jcnborges/TCC/monografia-tex/final.tex

%---------- Referencias ----------
\bibliography{reflatex} % geracao automatica das referencias a partir do arquivo reflatex.bib

\apendice
\chapter{Referência de Montagem do Robô}

A figura \ref{montagembellator} é uma composição de partes de fotos do robô Bellator em seu estágio final de montagem, ao final do projeto. A alimentação do motor em "2", bem como a ligação dos mesmos através da chave indicada abaixo de "9" na visão geral do robô, e a ligação dos outros componentes em "3" só deverão ser realizados após verificar todas as outras conexões do robô conforme indicadas na figura. Ligar incorretamente alguma das conexões pode levar à queima de componentes. Os cabos \emph{flat} devem ser conectados de modo a alinhar o \emph{GND} da placa de roteamento com o \emph{GND} da C8051F340 no \emph{port} correspondente. Também deve-se ficar atento ao nível de carga das baterias, que deverá ser de 10Volts ou mais. Após realizadas todas as conexões, a TS irá inicializar (cerca de 5 minutos) e poderá ser, enfim, utilizada conforme documentação em \ref{sec:ts}. A lista a seguir relaciona cada item numerado na figura com sua respectiva documentação ao longo do documento.

\begin{itemize}
\item 1 e 3) Especificação da C8051F340DK em \ref{sec:C8051F340DK}, TS 7260 em \ref{sec:espts7260} e placa de roteamento em \ref{sec:espplacaroteamento}.
\item 2) Especificação dos motores em \ref{sec:robobellator}.
\item 4 a 9) Diagramas esquemáticos e \emph{interface} da placa de roteamento com a C8051F340 em \ref{sec:desroteamento}.
\item Especificação dos Sensores e Encoders em \ref{sec:sensores} e \ref{sec:heds9700}.
\item 10) O pendrive contém o código executado na TS7260, descrito em \ref{sec:ts}.
\item 11) As pontes H são alimentadas pelos conectores de alimentação do motor.
\end{itemize}

\begin{figure}[H]
  \centering
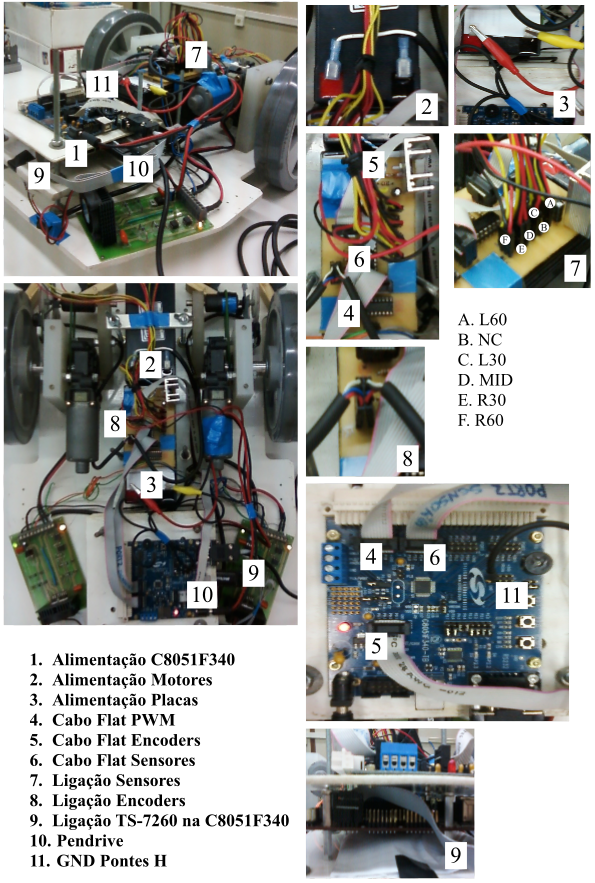
[picture p27: monografia-tex/figs/Montagem_Bellator.png]
  
  \caption[Referência de Montagem do Robô]
  {Referência de Montagem do Robô.}
  \label{montagembellator}
  \fonte{Autoria própria}
\end{figure}

\end{document}
