jcnborges/TCC/monografia-tex/monografia_bellator.tex

% estilo de documento abnTeX
\documentclass{abnt-UTFPR}

% estilo de bibliografia abnTeX
\usepackage[alf,abnt-emphasize=bf,bibjustif,recuo=0cm]{abntcite}	

\usepackage[brazil]{babel}							% pacote portugues brasileiro
\usepackage[latin1]{inputenc}						% pacote para acentuacao direta
\usepackage{amsmath,amsfonts,amssymb}				% pacote matematico
\usepackage{float}
\usepackage{graphicx}								% pacote grafico
\usepackage{pgf}									% Pacote grafico
\usepackage{tikz}									% Pacote para desenhar figuras
\usepackage{times}									% fonte times
\usepackage{verbatim}								% multi-line comment
\usetikzlibrary{arrows, backgrounds, fit, petri}	% Modulos tikz
\usetikzlibrary{positioning, shapes}				% Modulos tikz

\input{inicio}

\input{introducao}

\input{fund_teorica}

\input{desenvolvimento}

\input{concl}

\input{final}
