jcnborges/TCC/C8051F340/cyglink.txt

"C:\Coisas de Yuri\10Periodo\TCC\C8051F340\main.obj"  TO "C:\Coisas de Yuri\10Periodo\TCC\C8051F340\Firmware" RS(256) PL(68) PW(78)
