jcnborges/TCC/referencias/capa.pdf

UNIVERSIDADE TECNOLOGICA FEDERAL DO PARAN ´ | A´
DEPARTAMENTO ACADEMICO DE INFORM ˆ | ATICA ´
DEPARTAMENTO ACADEMICO DE ELETR ˆ | ONICA ˆ

### CURSO DE ENGENHARIA DE COMPUTAC¸AO˜

### ALEXANDRE JACQUES MARIN

### BRUNO WEINGRABER

### LUCAS CAMPIOLO PAIVA YURI ANTIN WERGRZN

## DESENVOLVIMENTO DO PROJETO BELLATOR

RELATORIO DE CONCLUS ´ | AO˜

CURITIBA

2010

### ALEXANDRE JACQUES MARIN

### BRUNO WEINGRABER

### LUCAS CAMPIOLO PAIVA YURI ANTIN WERGRZN

## DESENVOLVIMENTO DO PROJETO BELLATOR

Relat´orio apresentado `a Disciplina de Oficina de Integra¸c˜ao 3, do Departamento Acadˆemico de Inform´atica - DAINF - e do Departamento Acadˆemico de Eletrˆonica -DAELN - do Curso Superior de Engenharia de Computa¸c˜ao da Universidade Tecnol´ogica Federal do Paran´a - UTFPR, como requisito parcial para finaliza¸c˜ao da disciplina.

CURITIBA

2010
