jcnborges/TCC/monografia-tex/figs/bellator-1.png

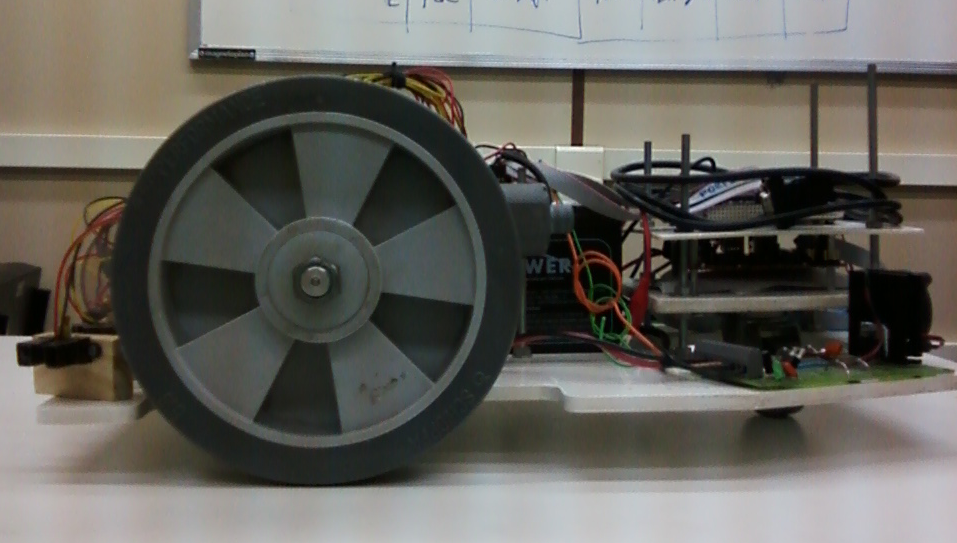
monografia-tex/figs/bellator-1.png
