jcnborges/TCC/monografia-tex/figs/bellator-2.png

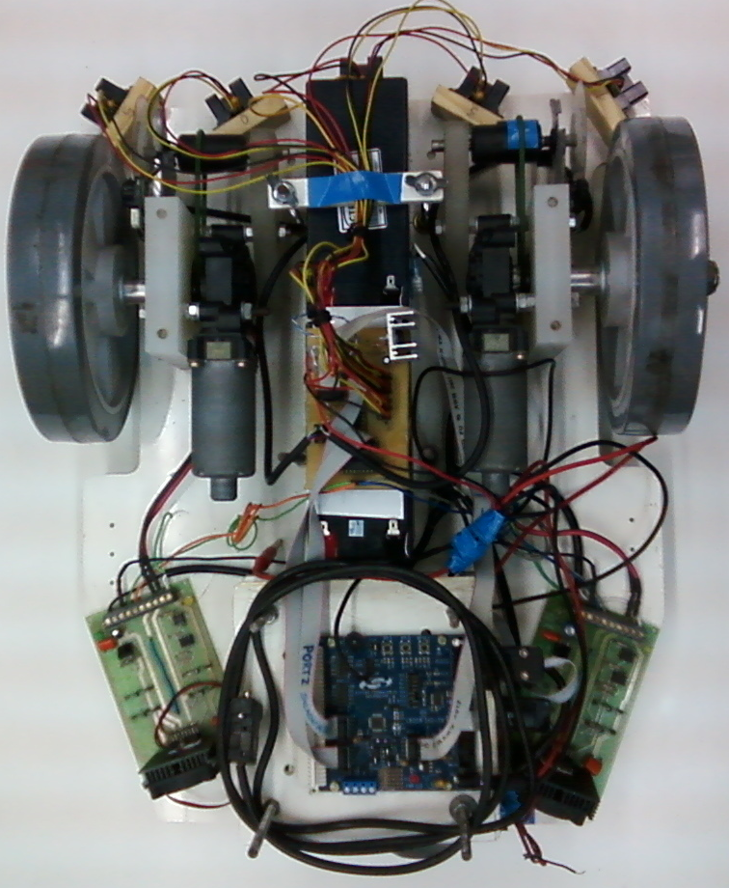
monografia-tex/figs/bellator-2.png
