jcnborges/TCC/monografia-tex/figs/bellator.jpg

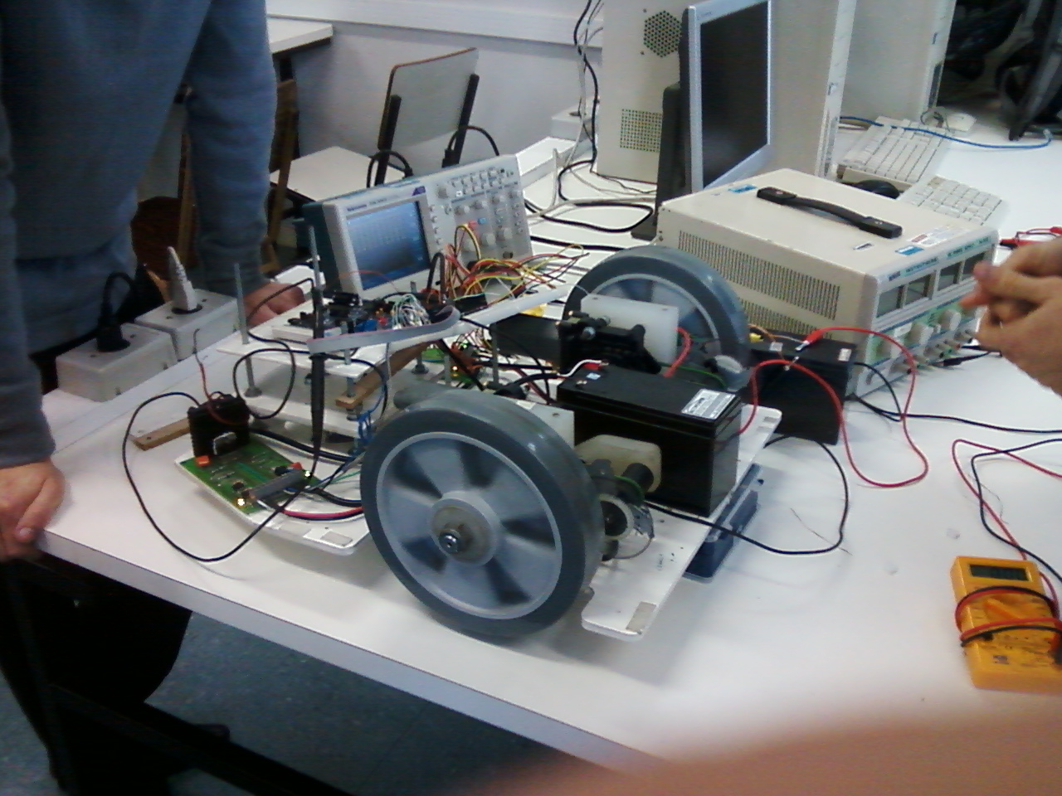
monografia-tex/figs/bellator.jpg
