jcnborges/TCC/monografia-tex/figs/dimsens.png

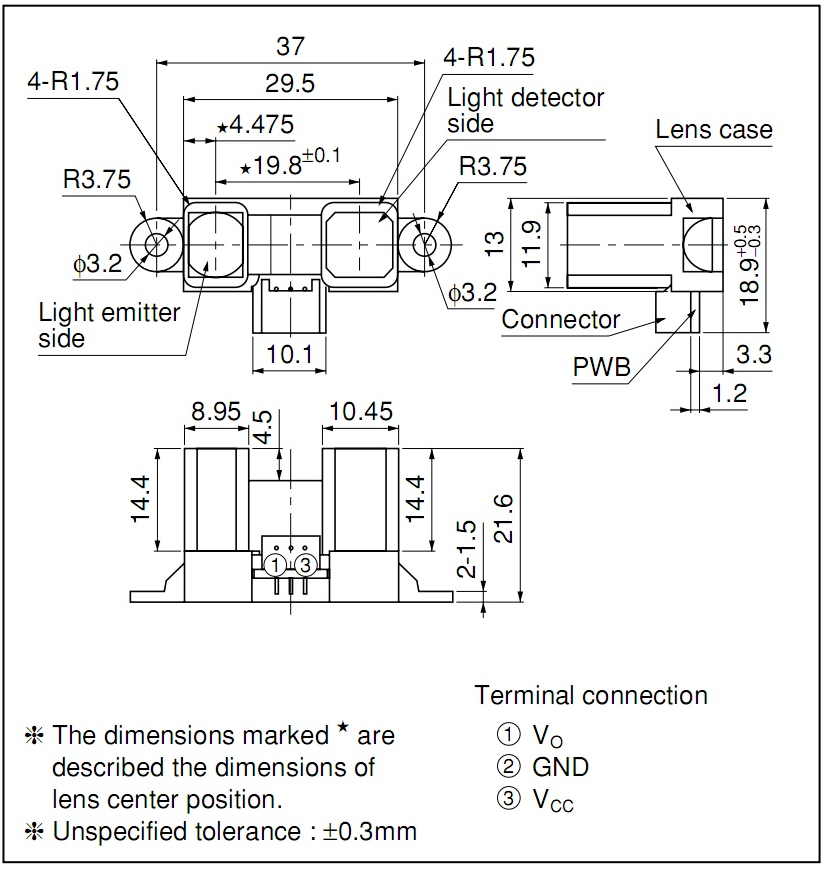
monografia-tex/figs/dimsens.png
