jcnborges/TCC/monografia-tex/figs/fcm_proposto.png

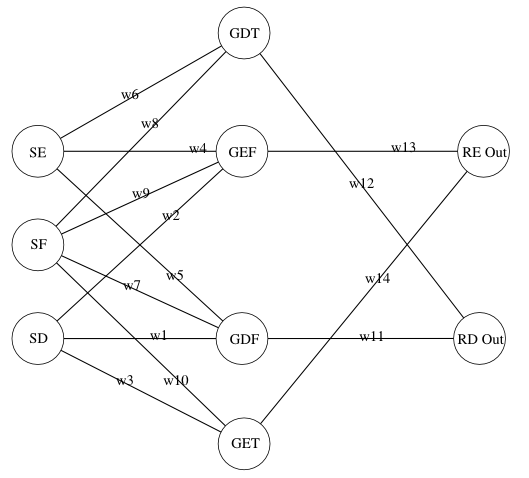
monografia-tex/figs/fcm_proposto.png
