jcnborges/TCC/monografia-tex/figs/fuzzyclasses.png

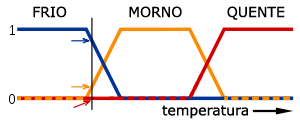
monografia-tex/figs/fuzzyclasses.png
