jcnborges/TCC/Placa_Roteamento_TCC/Default.png

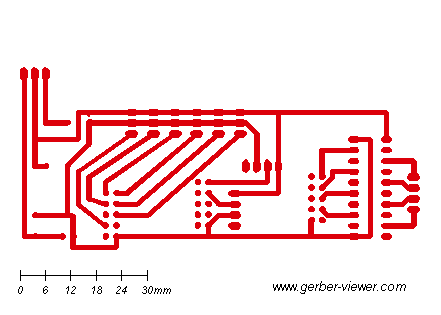
Placa_Roteamento_TCC/Default.png
