jcnborges/TCC/Placa_Roteamento_TCC/fotos_placa1.png

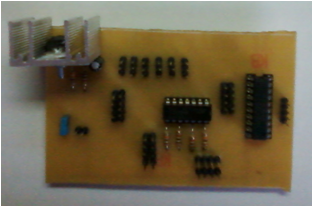
Placa_Roteamento_TCC/fotos_placa1.png
