jcnborges/TCC/Placa_Roteamento_TCC/fotos_placa2.png

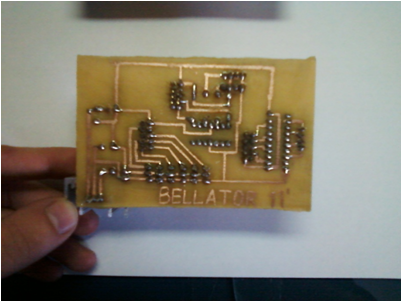
Placa_Roteamento_TCC/fotos_placa2.png
