jcnborges/TCC/Placa_Roteamento_TCC/imagem_board.PNG

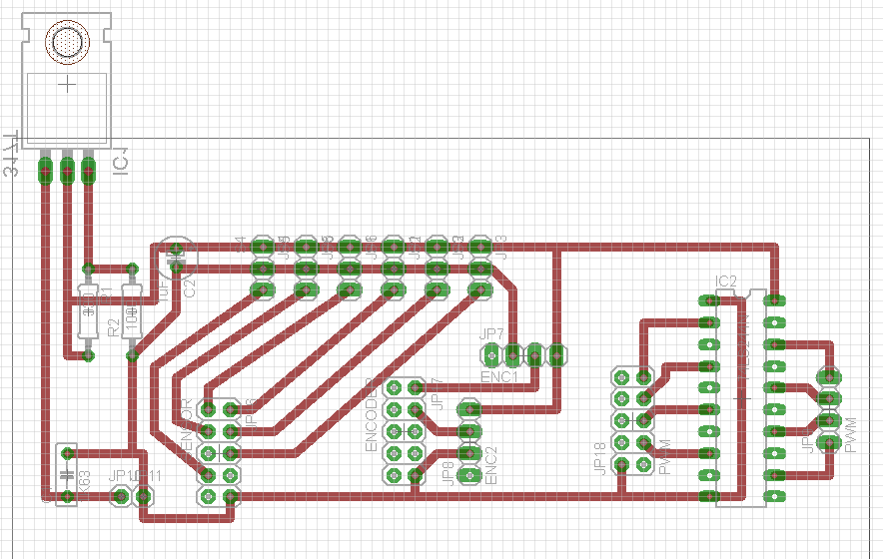
Placa_Roteamento_TCC/imagem_board.PNG
