jcnborges/TCC/algoritmos/FCM/projeto_fcm_bellator.ods

Conceito | Descrição
SE | Conceito de entrada com o valor absoluto do sensor de distância esquerdo
SF | Conceito de entrada com o valor absoluto do sensor de distância frontal
SD | Conceito de entrada com o valor absoluto do sensor de distância direito
GDF | Conceito de decisão representando a decisão de girar a roda direita para frente
GDT | Conceito de decisão representando a decisão de girar a roda direita para trás
GEF | Conceito de decisão representando a decisão de girar a roda esquerda para frente
GET | Conceito de decisão representando a decisão de girar a roda esquerda para trás
RD Out | Conceito de saída com o valor absoluto do setpoint de pwm da roda direita
RE Out | Conceito de saída com o valor absoluto do setpoint de pwm da roda esquerda
Relações causais | Descrição | Intensidade | Valor
w1 | SD influencia GDF | Forte | 1
w2 | SD influencia GEF | Média | 0,5
w3 | SD influencia GET | Forte | 1
w4 | SE influencia GEF | Forte | 1
w5 | SE influencia GDF | Média | 0,5
w6 | SE influencia GDT | Forte | 1
w7 | SF influencia GDF | Médio | 0,5
w8 | SF influencia GDT | Fraca | 0,125
w9 | SF influencia GEF | Médio | 0,5
w10 | SF influencia GET | Fraca | 0,125
w11 | GDF influencia RD Out | Forte | 1
w12 | GDT influencia RD Out | Forte | 1
w13 | GEF influencia RE Out | Forte | 1
w14 | GET influencia RE Out | Forte | 1
