jcnborges/TCC/C8051F340/flie/rule.h

// Project FLIE-Fuzzy Logic Inference Engine - João Alberto Fabro - out/1996
// Header File rule.h
#ifndef RULE
#define RULE
#define MAXRULES 150  // Maximum number of rules per rulebase for fuzzy_control

/* Class Rule - contains one rule of inference - can make inferences based on
 rules of 1, 2 or 3 predecessors and 1 sucessor. To define a rule, are necessary
 the fuzzy sets of predecessors and of the sucessor! Ex:

 if Tempsense is Xlarge and Levelsense is Large then HeatKnob is Alot

 needs the following definition of rule:

 rule.definerule(SenseTemp.getcat("Xlarge"),SenseLevel.getcat("Large"),
                   HeatKnob.getcat("Alot"));

*/



class rule : public TRegra
{

private:


public:
	trapezoid_category *inputcat1, *inputcat2, *inputcat3;

	trapezoid_category *outputcat;

        int num_inputs;

        float at1, at2, at3;

        rule();

	void definerule(trapezoid_category *input1,trapezoid_category *output);

	void definerule(trapezoid_category *input1,trapezoid_category *input2,trapezoid_category *output);

	void definerule(trapezoid_category *input1,trapezoid_category *input2,trapezoid_category *input3,

                        trapezoid_category *output);

	float evaluaterule(float &inputval1);
        float evaluaterule_memberships(float memb_input1);
        float evaluaterule(float &inputval1,float &inputval2);
        float evaluaterule_memberships(float memb_input1, float memb_input2);
        float evaluaterule(float &inputval1,float &inputval2,float &inputval3);
        float evaluaterule_memberships(float memb_input1, float memb_input2, float memb_input3);

	trapezoid_category *getoutputcategory();

        void clearinputcategoryactivations();

        void clearoutputcategoryactivations();

        void save_m(FILE *file);
        void save(FILE *file);

        void load(FILE *file);

        ~rule();
        void inserePremissa(trapezoid_category *tc);
        void insereConclusao(trapezoid_category *tc);
        void Notifica(trapezoid_category *at); // notifica a regra, chamado pelas inputcategories(subats)
        void Notifica_Conclusao();//Método que notifica a subat de saída, pois a regra foi disparada!

};
#endif
