jcnborges/TCC/(commit log)

2011-04-27 Template para criacao de TCC no tex
2011-05-05 roteiro para monografia
2011-05-09 Documentacao final de OI3 do Projeto Bellator
2011-06-02 Template para criação de tcc segundo normas do daeln-utfpr
2011-06-06 Mais testes. Descomentei o pacote para pontuacao direta.
2011-07-26 Lista de formatos a serem ignorados (.gitignore)
2011-07-27 Mais escrita.... As referências (por ex \ref{BELLATOR} não estão funcionando, não sei por que... Aparecem como ?? no texto
2011-08-16 - C8051F34x-DK.pdf (User guide kit) - Input power supply 7-15 VDC
2011-08-16 - Pinos do PWM atualizados - P1: 0, 2, 4, 6
2011-08-23 Esquemático da placa de roteamento. Falta revisar e fazer o board
    [PlacaSchematic.sch]
2011-08-30 - Arrumei a referência para a equação.
2011-08-30 - Configuração correta das interrupções dos encoders.
2011-08-30 placa e update monografia
    [PlacaSchematic.brd, PlacaSchematic.sch]
2011-09-06 -Adicionei o código matlab do algoritmo de navegação fcm
    [main.OBJ]
2011-09-06 Roteamento atualizado
    [PlacaSchematic.brd, PlacaSchematic.sch]
2011-09-13 -Tese de doutorado de Márcio Mendonça
2011-09-13 Roteamento atualizado/Gerber
    [PlacaSchematic.brd]
2011-09-20 placa roteamento versão pedreiro
    [PlacaSchematic.brd]
2011-09-20 placa roteamento versao pedreiro
    [PlacaSchematic_075.brd, PlacaSchematic_075.sch, PlacaSchematicbck.brd, PlacaSchematicbck.sch, PlacaSchematicbck2.brd, PlacaSchematicbck2.sch]
2011-09-24 Imagem do Board, versao que o julho está fazendo (.brd)
2011-09-27 +esquematico atualizado +inicio do desenvolvimento
    [PlacaSchematic.sch]
2011-09-29 Mais coisas sobre a placa de roteamento
2011-10-11 funcionou encoder
    [main.OBJ]
2011-10-13 placa roteamento atualizada
    [PlacaSchematic.brd, PlacaSchematic.sch]
2011-10-14 Placa roteamento finalizada (roteamento manual encoders)
    [PlacaSchematic.brd, PlacaSchematic.sch]
2011-10-16 -Estou seguinte a estrutura de tópicos do nosso relatório -Devemos apresentar apenas os tópicos existentes em nosso relatório
2011-10-16 -Completei o capítulo de FCM
2011-10-27 Adicionada pasta algoritmos para desenvolvimento do código para a TS
2011-10-29 -Cronogramas e atas
    [Cronograma_Reuni�o_25_10_2011.xlsx]
2011-11-01 Codigo inicial para a TS, protocolo simplificado
2011-11-03 Novo codigo para teste do robo (tslogic) Teste com o robo funcionou, acelerando as duas rodas ate o maximo e desacelerando ate parar
2011-11-03 mini atualizacao c8051f340
    [main.OBJ]
2011-11-08 Nova versao flie, falta fazer makefile
    [main.OBJ]
2011-11-10 Flie atualizado Problema: Defuzzified output para o caso perto é sempre 2.5
    [main.OBJ]
2011-11-17 -Criado novo arquivo de projeto (.uv2). -Removido arquivo de workspace.
    [main.OBJ]
2011-11-17 -Criado arquivo de projeto .uv2 para ser aberto no Keil uVision 3 para usar o simulador.
2011-11-22 Monitor serial e script para matar processo
2011-11-29 Testes sensores distancia
    [distancia sensor.ods]
2011-11-29 Testes sensores
2011-11-29 update algoritmo + excel c. polinomial
    [polinomial.xlsx]
2011-12-01 flie, primeira versao pronta para testes
2011-12-01 App_monitor controlando os motores
2011-12-08 ultima do ano... ou nao
    [Cronograma_Reuni�o_25_10_2011.xlsx]
2012-01-09 Cronograma 2012
    [Cronograma-2012.ods]
2012-01-09 Limpeza do código FCM
    [Cronograma-2012.ods]
2012-01-12 Artigos de FCM em navegacao robotica
2012-01-12 Atualizei a revisao de FCM (mas falta coisa ainda)
2012-01-12 Corrigido o problema de encoding no arquivo fund_teorica
2012-01-13 Terminei um exemplo de FCM, falta o outro.
2012-01-16 Atualizei segundo exemplo de FCM com tabela.
2012-01-17 Inclui os tipos de conceito e relacionamentos suportados pelo FCM na revisão.
2012-01-18 pinos pwm trocados
2012-01-18 Atualizei fundamentação de FCM
2012-01-19 Makefile para a monografia
2012-01-19 Fundamentação teórica de Fuzzy revisada, ainda incompleta
2012-01-19 Atualizei o segundo exemplo de FCM.
2012-01-19 Correção das aspas, correções de formatação
2012-01-19 Pacote tikz para desenhar imagens, versao inicial do diagrama do software tslogic
2012-01-23 Robo andando e desviando de obstaculos (fuzzy)
2012-01-25 Codigo FCM implementado.
    [projeto_fcm_bellator.ods]
2012-01-27 Corrigi um bug no código fcm e comecei a escrever o desenvolvimento do projeto FCM
    [fcm.cpp]
2012-01-27 Atualizei o projeto e implementação do FCM, inclui uma figura e modifiquei objetivos.
    [projeto_fcm_bellator.ods]
2012-01-31 Pacote float para posicionar as figuras/tabelas
2012-02-01 Arrumado o problema com a biblioteca iostream.h
    [FIE.cc, flie.cc, flie.h, fuzzfier.cc, fuzzy_control.cc, lingvar.cc, rule.cc]
2012-02-03 Atualizei o desenvolvimento do projeto FCM, fiz alguns comentários no código FCM e terminei considerações na parte de FCM da fundamentação.
2012-02-07 Inclui a ata da reunião de hoje
2012-02-07 correção de erros
2012-02-09 inicio.tex - Ano alterado para 2012 introducao.tex - Mudei alguns textos + Correções fund_teorica.tex - Correções desenvolvimento.tex - Inicio da seção sobre testes e alteração da introdução do capít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
2012-02-10 Ajusta os pesos de acordo com um limiar da distancia normalizada 'sd'.
2012-02-10 Ajusta os pesos de acordo com um limiar da distancia normalizada 'sf'.
2012-02-10 Lista de siglas e símbolos comentadas no código por não estarem em uso no momento
2012-02-13 o dia em que nada funcionou
2012-02-14 Rotina de testes motores, deploy mais detalhado
2012-02-22 Atualizei os arquivos de referencia bibliografica de FCM
2012-02-22 Projeto de FCM atualizado
2012-02-24 Escrita a correção do algoritmo FCM através de um evento
2012-02-26 Correções na parte de FCM
2012-02-27 Atualizado capítulo de conclusão
2012-02-28 Revisado introdução, fundamentação, incluido figura do encoder em fundamentação, corrigido bug no testesresultados, atualizado referências, incluido encoder.
2012-02-28 figura curva interpolada
    [polinomial.xlsx]
2012-02-28 Curva dos sensores (desenvolvimento), correções (conclusão)
2012-03-05 Modifiquei as citações de FCM para ED-FCM, deixando claro que o algoritmo implementado é ED-FCM e inclui a explicação de PWM na fundamentação com a devida referencia.
2012-03-07 Corrigido erro de ortografia e divisão silábica
2012-03-23 Corrigi citação inválida e o título inglês para 'Mobile Robot Development and Qualitative Analysis of Fuzzy Navigation Algorithms'
2012-03-26 Última revisão do PDF. Servirá de marco para encerramento do projeto. Abs.
